Baigel/FES-Controller-Firmware/FES-Firmware/README.md

v1 uses a FreeRTOS implementation, while v2 is does not uses RTOS and utilizes interrupts more.
