Baigel/FES-Controller-Firmware/Bill_of_Materials.xlsx

Schematic Reference | Item | Quantity | Cost (Individual) | Cost (Total) | Link
R1 | 10k (5%) SMD Resistor (0805) | 1 | $0.176 | 0.176 | https://au.mouser.com/ProductDetail/Vishay-Dale/CRCW0805110KJNEA?qs=sGAEpiMZZMskC5GgilGuvswCRu5OcvqE
R3,R7,R8 | 100 (5%) SMD Resistor (0805) | 3 | $0.743 | 2.229 | https://au.mouser.com/ProductDetail/Bourns/CHP0805AJW-100ELF?qs=sGAEpiMZZMv0NwlthflBi6fCq2I1qbGXQIr7hlPPSkk%3D
R4,R5 | 10 (5%) SMD Resistor (0805) | 2 | $0.135 | 0.270 | https://au.mouser.com/ProductDetail/Bourns/CR0805-JW-101ELF?qs=sGAEpiMZZMtJuH53xR2FXOBz8%2FbVOc0E
R6 | 1 (5%) SMD Resistor (0805) | 1 | $0.297 | 0.297 | https://au.mouser.com/ProductDetail/KOA-Speer/SG73P2ARTTD1R0J?qs=JC%252B8NssjmpAPEA4%252BfFwkHg%3D%3D
R9 | 3.6k (5%) SMD Resistor (0805) | 1 | $0.176 | 0.176 | https://au.mouser.com/ProductDetail/Vishay-Dale/CRCW08053K60JNTA?qs=sGAEpiMZZMsxiS4eJwGuBkuyMnZPcGTj
RV1 | 2K Potentiometer (3296W) | 1 | $2.350 | 2.350 | https://au.mouser.com/ProductDetail/Bourns/3296W-1-202ALF?qs=pLJKYPamQJyHBk2f%2Fk5bUg%3D%3D
C1,C2,C3,C4,C7,C14 | 0.1u (20%) SMD Capacitor (1206) | 6 | $0.176 | 1.056 | https://au.mouser.com/ProductDetail/KEMET/C1206C104M5RAC7800
C5 | 4.7n (10%) SMD Capacitor (0603) | 1 | $0.621 | 0.621 | https://au.mouser.com/ProductDetail/KEMET/C0603C472K1TACAUTO
C6,C10 | 470uF Electrolytic Capacitor | 2 | $2.160 | 4.320 | https://au.mouser.com/ProductDetail/EPCOS-TDK/B41866C8477M000?qs=nadT%2FcWsIvAnzwBaAOFIjw%3D%3D
C8 | 1u (10%) SMD Capacitor (1206) | 1 | $0.203 | 0.203 | https://au.mouser.com/ProductDetail/Samsung-Electro-Mechanics/CL31B105KAHNFNE
C9,C11,C12,C13 | 10u (10%) SMD Capacitor (1206) | 4 | $0.311 | 1.244 | https://au.mouser.com/ProductDetail/Samsung-Electro-Mechanics/CL31A106KPHNNNE
U1 | STM32L432KB | 1 | $8.140 | 8.140 | https://au.mouser.com/ProductDetail/STMicroelectronics/STM32L432KBU6?qs=qzCNEk%252BRr%252BbQvfxQ4ZNP4A%3D%3D
U2 | TL072 | 1 | $1.730 | 1.730 | https://au.mouser.com/ProductDetail/Texas-Instruments/TL072ACP?qs=sGAEpiMZZMv0NwlthflBi0v6ZMi0LuMc
U3 | MMPQ2907A | 1 | $2.520 | 2.520 | https://au.mouser.com/ProductDetail/onsemi-Fairchild/MMPQ2907A?qs=SSucg2PyLi75j4vPquCO%252BA%3D%3D
U4 | INA240A3PW | 1 | $4.670 | 4.670 | https://au.mouser.com/ProductDetail/Texas-Instruments/INA240A3PWR?qs=S8zVn2bBIh8wFowK%252B7XgMA%3D%3D
Q1 | BC547B | 1 | $0.648 | 0.648 | https://au.mouser.com/ProductDetail/onsemi-Fairchild/BC547B?qs=UMEuL5FsraB3zD25tclGGQ%3D%3D
S1 | HV2601 | 1 | $28.620 | 28.620 | https://au.mouser.com/ProductDetail/Microchip-Technology/HV2601FG-G?qs=sGAEpiMZZMvCgIIVhD0CyvtYN5u6mJzB
PS1 | MCP1700-3302E | 1 | $0.581 | 0.581 | https://au.mouser.com/ProductDetail/Microchip-Technology/MCP1700-3302E-TO
PS2 | RH-0515D | 1 | $11.110 | 11.110 | https://au.mouser.com/ProductDetail/RECOM-Power/RH-0515D?qs=YWgezujkI1I0O2RytZapjw%3D%3D
PS3 | R05-100B | 1 | $65.160 | 65.160 | https://au.mouser.com/ProductDetail/RECOM-Power/R05-100B
J1,J3 | Screw Terminal (x2) | 2 | $1.320 | 2.640 | https://au.mouser.com/ProductDetail/Phoenix-Contact/1709328
J2 | J-Link Header | 1 | $0.851 | 0.851 | https://au.mouser.com/ProductDetail/Amphenol-Commercial-Products/G821EU210AAL10Y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
J4 | Screw Terminal (x8) | 1 | $8.880 | 8.880 | https://au.mouser.com/ProductDetail/Phoenix-Contact/1725711?qs=W3wJikR1%252BS7n1cN8b%252BRI%2FQ%3D%3D
J5 | Screw Terminal (x3) | 1 | $2.000 | 2.000 | https://au.mouser.com/ProductDetail/Phoenix-Contact/1880847?qs=2WS7V4AoKFoqh0T97upJAQ%3D%3D
 |  |  | Total Cost | 150.492
