Baigel/FES-Controller-Firmware/FES-Controller-Schematic.pdf

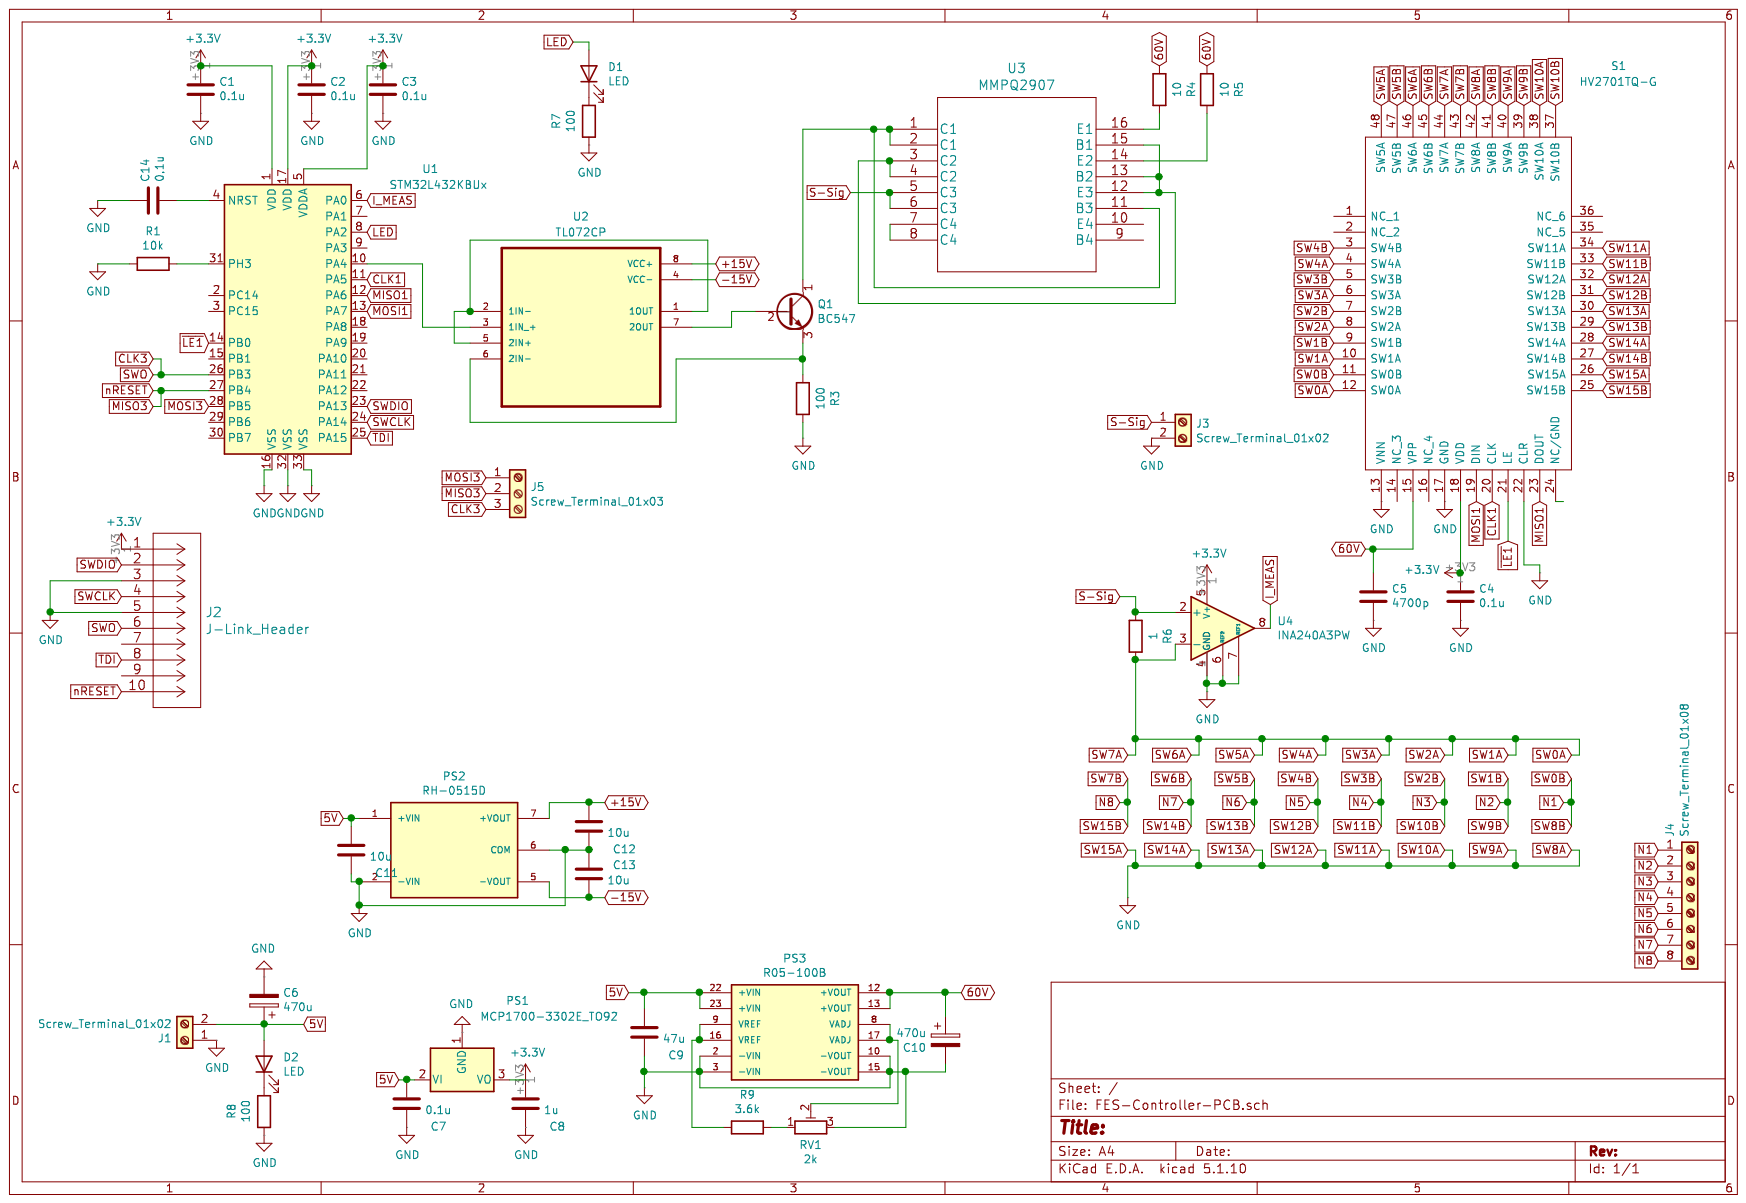
[picture p5: page 1]
