Baigel/FES-Controller-Firmware/FES-Firmware/FES-Controller-v2.0/FES-Controller.ioc

Mcu.UserName=STM32L432KCUx
PA0.Signal=ADCx_IN5
PA1.Signal=SPI1_SCK
PA2.Signal=ADCx_IN7
PA4.Signal=COMP_DAC11_group
PA5.Signal=COMP_DAC12_group
PA6.Signal=SPI1_MISO
PA7.Signal=SPI1_MOSI
PA8.Signal=GPIO_Output
PA9.Signal=GPIO_Output
PB0.Signal=SPI1_NSS
PB5.Signal=SPI3_MOSI
