Baigel/FES-Controller-Firmware/FES-Firmware/FES-Controller-v2.0/Core/Src/main.c

/**
  ******************************************************************************
  * @file			: main.c
  * @brief			: Main program body
  * @author			: Ahmed Hafeez-Baig
  ******************************************************************************
*/

/* Includes ------------------------------------------------------------------*/
#include "main.h"

/* Private function prototypes */
void SystemClock_Config(void);

/**
  * @brief
  * @retval int
  */
int main(void)
{
	/* Reset of all peripherals, Initializes the Flash interface and the Systick. */
	HAL_Init();

	/* Configure the system clock */
	SystemClock_Config();

	/* Task Initialization */
	fes_wavegen_task_init();
	fes_slave_SPI_task_init();
	
	USART2_UART_Init(); // TEMPORARY

	/* Infinite loop */
	while (1) {
		/* Run Each Task Sequentially */
		fes_wavegen_task();
		fes_slave_SPI_task();
	}
}

// TODO: Add function descriptions
// TODO: Cpp linting
// TODO: Update the central controller SPI library

/**
  * @brief System Clock Configuration
  * @retval None
  */
void SystemClock_Config(void) {
	RCC_OscInitTypeDef RCC_OscInitStruct = {0};
	RCC_ClkInitTypeDef RCC_ClkInitStruct = {0};

	/* Configure the main internal regulator output voltage */
	if (HAL_PWREx_ControlVoltageScaling(PWR_REGULATOR_VOLTAGE_SCALE1) != HAL_OK) {
		Error_Handler();
	}
	/* Initializes the RCC Oscillators according to the specified parameters
	 * in the RCC_OscInitTypeDef structure. */
	RCC_OscInitStruct.OscillatorType = RCC_OSCILLATORTYPE_MSI;
	RCC_OscInitStruct.MSIState = RCC_MSI_ON;
	RCC_OscInitStruct.MSICalibrationValue = 0;
	RCC_OscInitStruct.MSIClockRange = RCC_MSIRANGE_6;
	RCC_OscInitStruct.PLL.PLLState = RCC_PLL_ON;
	RCC_OscInitStruct.PLL.PLLSource = RCC_PLLSOURCE_MSI;
	RCC_OscInitStruct.PLL.PLLM = 1;
	RCC_OscInitStruct.PLL.PLLN = 40;
	RCC_OscInitStruct.PLL.PLLP = RCC_PLLP_DIV7;
	RCC_OscInitStruct.PLL.PLLQ = RCC_PLLQ_DIV2;
	RCC_OscInitStruct.PLL.PLLR = RCC_PLLR_DIV2;
	if (HAL_RCC_OscConfig(&RCC_OscInitStruct) != HAL_OK) {
		Error_Handler();
	}
	/* Initializes the CPU, AHB and APB buses clocks */
	RCC_ClkInitStruct.ClockType = RCC_CLOCKTYPE_HCLK|RCC_CLOCKTYPE_SYSCLK
								|RCC_CLOCKTYPE_PCLK1|RCC_CLOCKTYPE_PCLK2;
	RCC_ClkInitStruct.SYSCLKSource = RCC_SYSCLKSOURCE_PLLCLK;
	RCC_ClkInitStruct.AHBCLKDivider = RCC_SYSCLK_DIV1;
	RCC_ClkInitStruct.APB1CLKDivider = RCC_HCLK_DIV1;
	RCC_ClkInitStruct.APB2CLKDivider = RCC_HCLK_DIV1;

	if (HAL_RCC_ClockConfig(&RCC_ClkInitStruct, FLASH_LATENCY_4) != HAL_OK) {
		Error_Handler();
	}
}

/**
  * @brief  This function is executed in case of error occurrence.
  * @retval None
  */
void Error_Handler(void) {
	__disable_irq();
	while (1) {;}
}

#ifdef  USE_FULL_ASSERT
/**
  * @brief  Reports the name of the source file and the source line number
  *         where the assert_param error has occurred.
  * @param  file: pointer to the source file name
  * @param  line: assert_param error line source number
  * @retval None
  */
void assert_failed(uint8_t *file, uint32_t line) {
}
#endif
